maxakuru/esp32-n64/README.md

# esp32-n64

Bluetooth HID gamepad firmware for ESP32. Schematics & designs to fit a USB N64 controller shell.

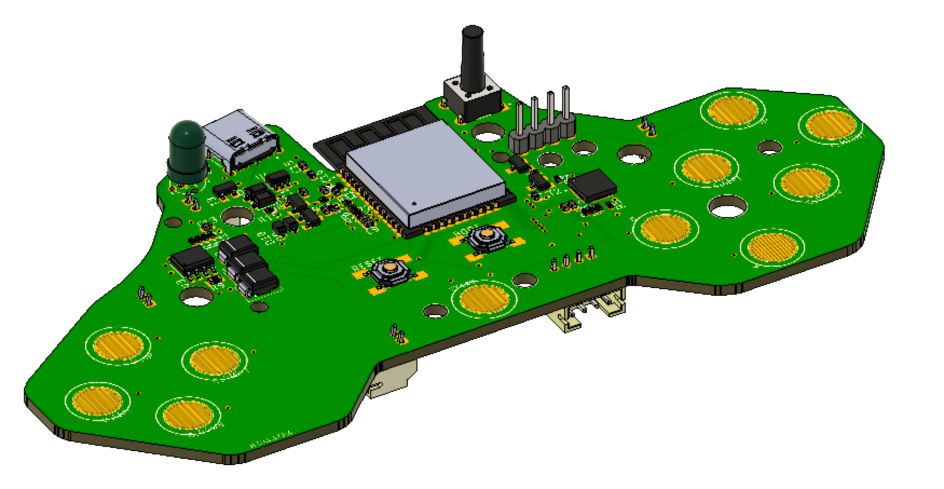
[picture p1: assets/images/board.png]
pcb
