maxakuru/esp32-n64/(threads)

Thread 1 (2022-07-19):

connection problems, android.

davidxgames, 2022-07-19:
hello, i saw your project and it's great, i compiled it and uploaded it to esp32 but when trying to connect to my android phone it gives an error, it's not compatible with android?

davidxgames, 2022-07-19:
i'm using a esp32 dev kit

maxakuru, 2022-07-24:
@davidxgames could you share more details about the error?

This project is still early dev, but I'll try to take a look at an Android phone in the next couple weeks if I can find a device to test with (I use ios). I was able to connect to my Shield TV which uses android, though..
