maxakuru/esp32-n64/assets/pcb/esp-n64.brd

## EAGLE design assets/pcb/esp-n64.brd (2022-07-11)

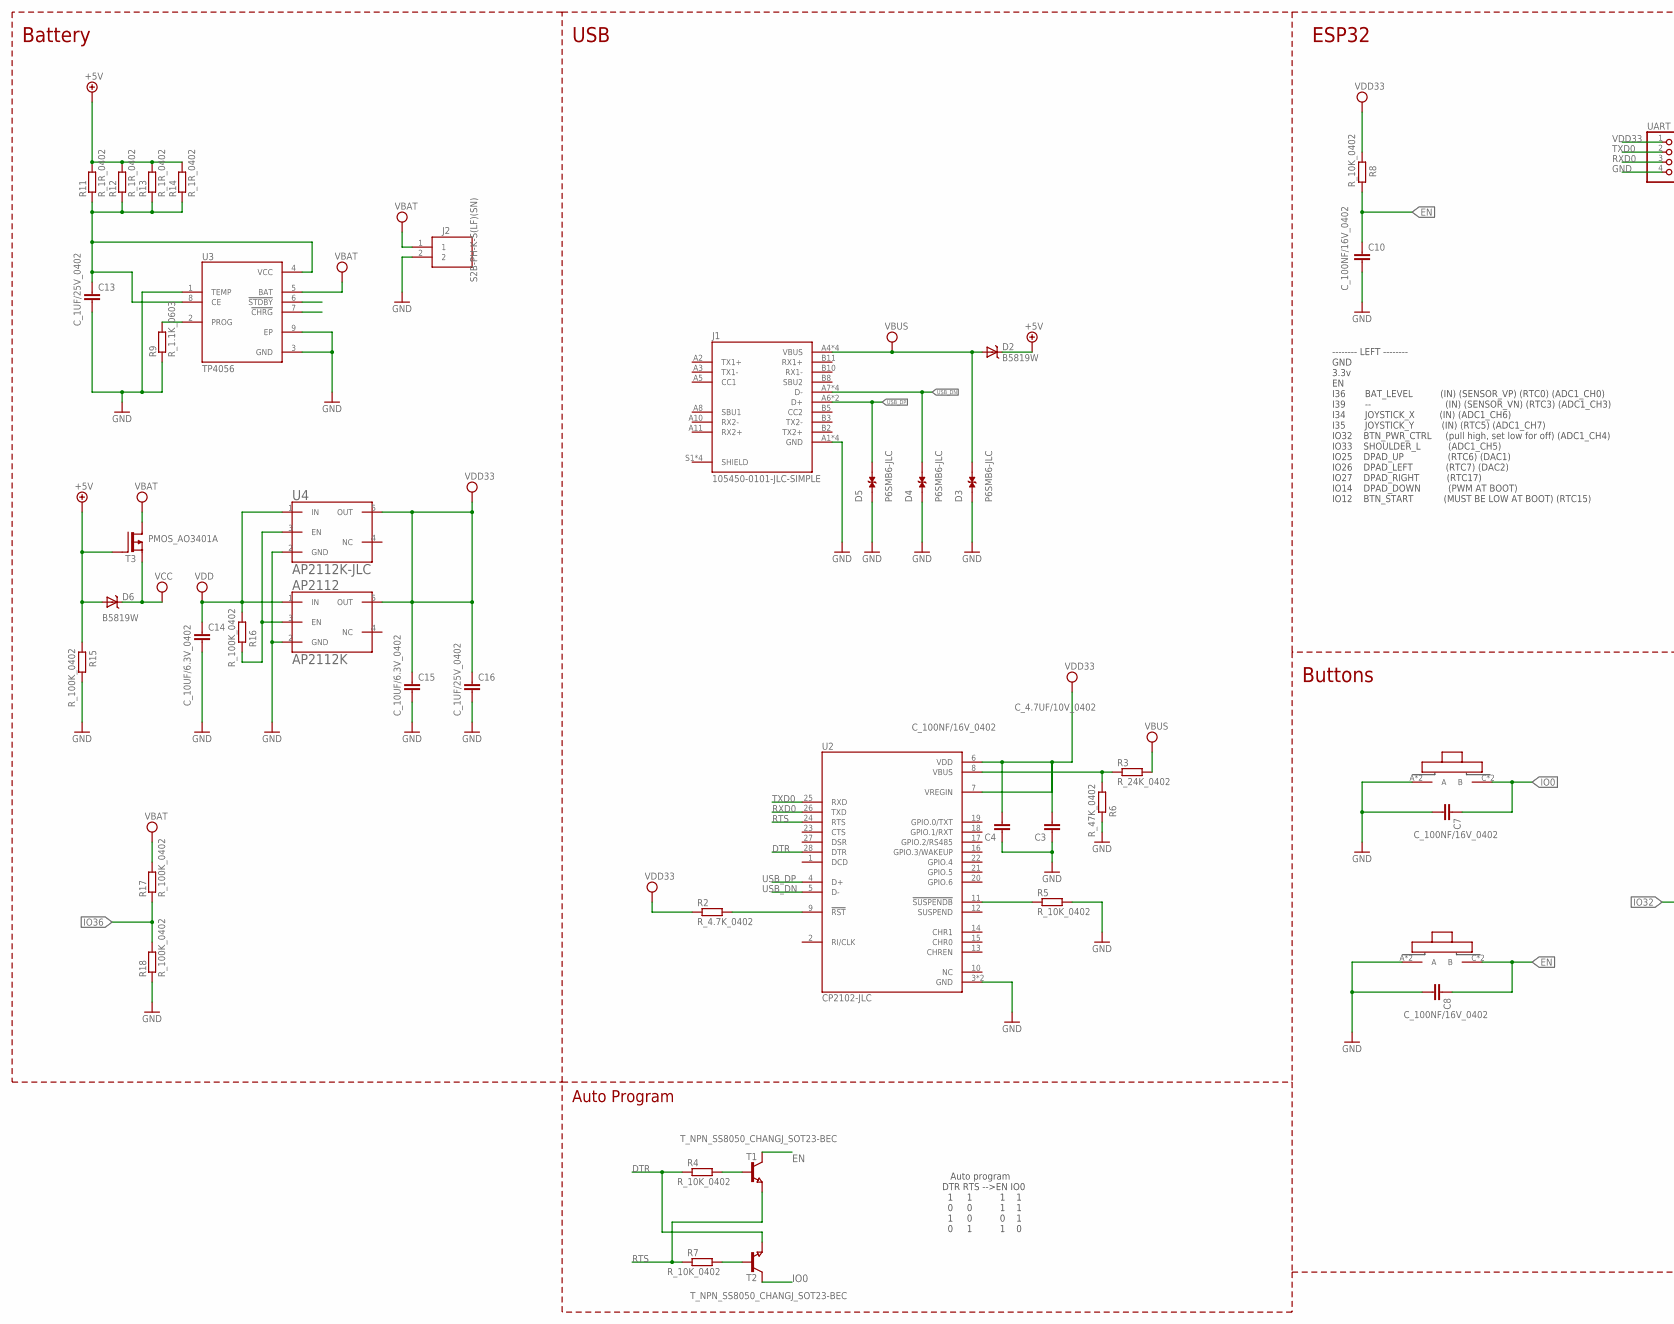
[picture p2: schematic esp-n64.sch, part in row 1, column 1]

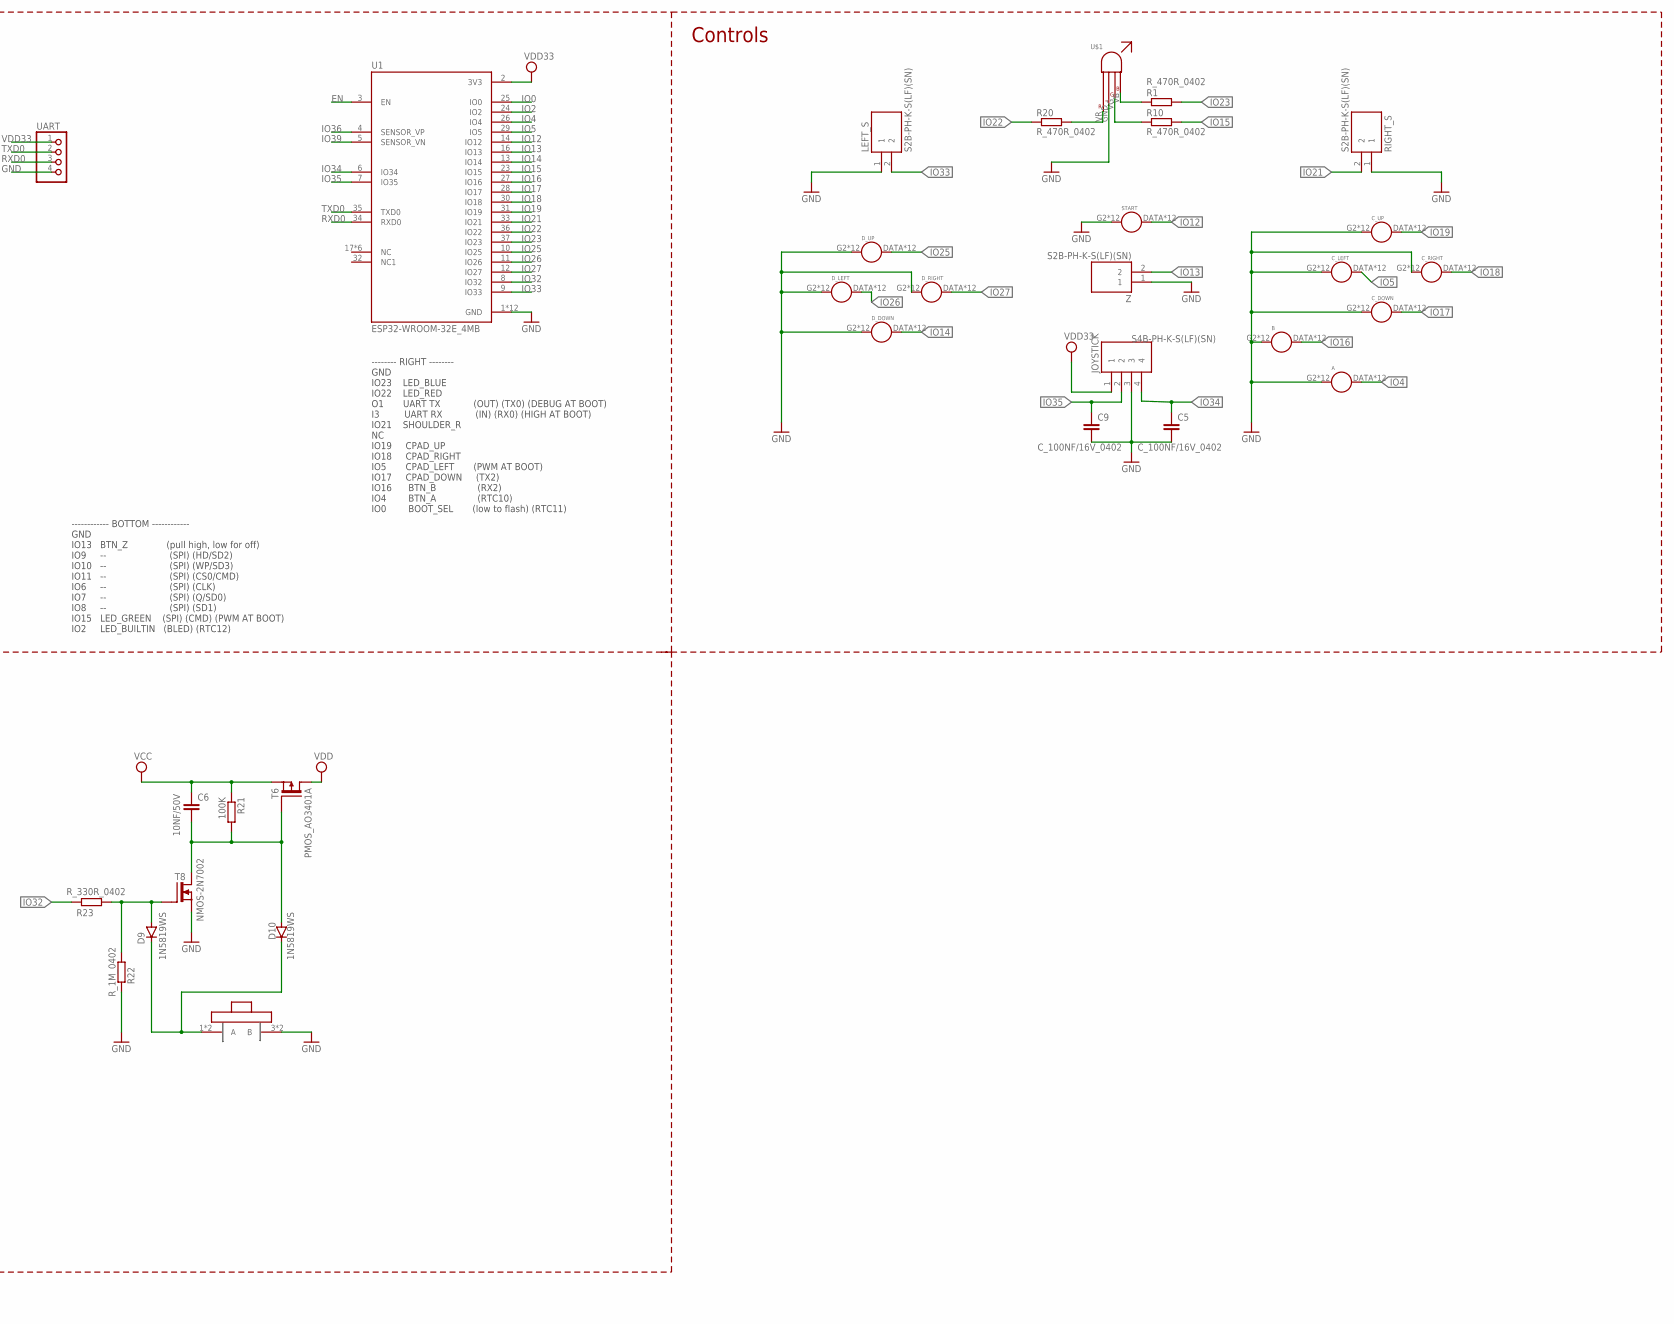
[picture p3: schematic esp-n64.sch, part in row 1, column 2]

Parts:
A: BUTTONPCB-CONDUCTIVE; BUTTON-PAD
AP2112: AP2112K; SOT-23-5
B: BUTTONPCB-CONDUCTIVE; BUTTON-PAD
BOOT: TS1187-SIMPLE; TS1187
C3: C_4.7UF/10V_0402; C0402
C4, C5, C7, C8, C9, C10: C_100NF/16V_0402; C0402
C6: 10NF/50V; C0402
C13, C16: C_1UF/25V_0402; C0402
C14, C15: C_10UF/6.3V_0402; C0402
CTRL: FSM14J-SIMPLE; SW_FSM14J
C_DOWN: BUTTONPCB-CONDUCTIVE; BUTTON-PAD
C_LEFT: BUTTONPCB-CONDUCTIVE; BUTTON-PAD
C_RIGHT: BUTTONPCB-CONDUCTIVE; BUTTON-PAD
C_UP: BUTTONPCB-CONDUCTIVE; BUTTON-PAD
D2, D6: B5819W; SOD-123
D3, D4, D5: P6SMB6-JLC; P6SMB6
D9, D10: 1N5819WS; SOD323
D_DOWN: BUTTONPCB-CONDUCTIVE; BUTTON-PAD
D_LEFT: BUTTONPCB-CONDUCTIVE; BUTTON-PAD
D_RIGHT: BUTTONPCB-CONDUCTIVE; BUTTON-PAD
D_UP: D_UP; BUTTON-PAD
J1: 105450-0101-JLC-SIMPLE; MOLEX_105450-0101-SIMPLE
J2: S2B-PH-K-S(LF)(SN); JST_S2B-PH-K-S(LF)(SN)
JOYSTICK: S4B-PH-K-S(LF)(SN); JST_S4B-PH-K-S(LF)(SN)
LEFT_S: S2B-PH-K-S(LF)(SN); JST_S2B-PH-K-S(LF)(SN)
R1, R10, R20: R_470R_0402; R0402
R2: R_4.7K_0402; R0402
R3: R_24K_0402; R0402
R4, R5, R7, R8: R_10K_0402; R0402
R6: R_47K_0402; R0402
R9: R_1.1K_0603; R0603
R11, R12, R13, R14: R_1R_0402; R0402
R15, R16, R17, R18: R_100K_0402; R0402
R21: 100K; R0402
R22: R_1M_0402; R0402
R23: R_330R_0402; R0402
RESET: TS1187-SIMPLE; TS1187
RIGHT_S: S2B-PH-K-S(LF)(SN); JST_S2B-PH-K-S(LF)(SN)
START: BUTTONPCB-CONDUCTIVE; BUTTON-PAD
T1, T2: T_NPN_SS8050_CHANGJ_SOT23-BEC; SOT23
T3, T6: PMOS_AO3401A; SOT23
T8: NMOS-2N7002; SOT23
U1: ESP32-WROOM-32E_4MB; ESP32-WROOM-32E
U2: CP2102-JLC; QFN50P500X500X80-29N
U3: TP4056; SOP127P600X175-9N
U4: AP2112K-JLC; SOT-23-5
U$1: RGB-LED; 1X04-LED-RGB
UART: PINHD-1X4; 1X04
Z: S2B-PH-K-S(LF)(SN); JST_S2B-PH-K-S(LF)(SN)

Connections:
+5V: D2.C, D6.A, R11.2, R12.2, R13.2, R14.2, R15.2, T3.1 (G)
DTR: R4.1, T2.2 (E), U2.28 (DTR)
EN: C8.1, C10.1, R8.1, RESET.C (B), RESET.D (B), T1.3 (C), U1.3 (EN)
GND: A.G2 (GND), A.G3 (GND), A.G4 (GND), A.G5 (GND), A.G6 (GND), A.G7 (GND), A.G8 (GND), A.G9 (GND), A.G10 (GND), A.G11 (GND), A.G12 (GND), A.GND, AP2112.2 (GND), B.G2 (GND), B.G3 (GND), B.G4 (GND), B.G5 (GND), B.G6 (GND), B.G7 (GND), B.G8 (GND), B.G9 (GND), B.G10 (GND), B.G11 (GND), B.G12 (GND), B.GND, BOOT.A, BOOT.B (A), C3.1, C4.1, C5.2, C7.2, C8.2, C9.2, C10.2, C13.2, C14.2, C15.2, C16.2, CTRL.3 (B), CTRL.4 (B), C_DOWN.G2 (GND), C_DOWN.G3 (GND), C_DOWN.G4 (GND), C_DOWN.G5 (GND), C_DOWN.G6 (GND), C_DOWN.G7 (GND), C_DOWN.G8 (GND), C_DOWN.G9 (GND), C_DOWN.G10 (GND), C_DOWN.G11 (GND), C_DOWN.G12 (GND), C_DOWN.GND, C_LEFT.G2 (GND), C_LEFT.G3 (GND), C_LEFT.G4 (GND), C_LEFT.G5 (GND), C_LEFT.G6 (GND), C_LEFT.G7 (GND), C_LEFT.G8 (GND), C_LEFT.G9 (GND), C_LEFT.G10 (GND), C_LEFT.G11 (GND), C_LEFT.G12 (GND), C_LEFT.GND, C_RIGHT.G2 (GND), C_RIGHT.G3 (GND), C_RIGHT.G4 (GND), C_RIGHT.G5 (GND), C_RIGHT.G6 (GND), C_RIGHT.G7 (GND), C_RIGHT.G8 (GND), C_RIGHT.G9 (GND), C_RIGHT.G10 (GND), C_RIGHT.G11 (GND), C_RIGHT.G12 (GND), C_RIGHT.GND, C_UP.G2 (GND), C_UP.G3 (GND), C_UP.G4 (GND), C_UP.G5 (GND), C_UP.G6 (GND), C_UP.G7 (GND), C_UP.G8 (GND), C_UP.G9 (GND), C_UP.G10 (GND), C_UP.G11 (GND), C_UP.G12 (GND), C_UP.GND, D3.1, D4.1, D5.1, D_DOWN.G2 (GND), D_DOWN.G3 (GND), D_DOWN.G4 (GND), D_DOWN.G5 (GND), D_DOWN.G6 (GND), D_DOWN.G7 (GND), D_DOWN.G8 (GND), D_DOWN.G9 (GND), D_DOWN.G10 (GND), D_DOWN.G11 (GND), D_DOWN.G12 (GND), D_DOWN.GND, D_LEFT.G2 (GND), D_LEFT.G3 (GND), D_LEFT.G4 (GND), D_LEFT.G5 (GND), D_LEFT.G6 (GND), D_LEFT.G7 (GND), D_LEFT.G8 (GND), D_LEFT.G9 (GND), D_LEFT.G10 (GND), D_LEFT.G11 (GND), D_LEFT.G12 (GND), D_LEFT.GND, D_RIGHT.G2 (GND), D_RIGHT.G3 (GND), D_RIGHT.G4 (GND), D_RIGHT.G5 (GND), D_RIGHT.G6 (GND), D_RIGHT.G7 (GND), D_RIGHT.G8 (GND), D_RIGHT.G9 (GND), D_RIGHT.G10 (GND), D_RIGHT.G11 (GND), D_RIGHT.G12 (GND), D_RIGHT.GND, D_UP.G2 (GND), D_UP.G3 (GND), D_UP.G4 (GND), D_UP.G5 (GND), D_UP.G6 (GND), D_UP.G7 (GND), D_UP.G8 (GND), D_UP.G9 (GND), D_UP.G10 (GND), D_UP.G11 (GND), D_UP.G12 (GND), D_UP.GND, J1.A1 (GND), J1.A12 (GND), J1.B1 (GND), J1.B12 (GND), J2.2, JOYSTICK.3, LEFT_S.1, R5.2, R6.1, R9.1, R15.1, R18.1, R22.2, RESET.A, RESET.B (A), RIGHT_S.1, START.G2 (GND), START.G3 (GND), START.G4 (GND), START.G5 (GND), START.G6 (GND), START.G7 (GND), START.G8 (GND), START.G9 (GND), START.G10 (GND), START.G11 (GND), START.G12 (GND), START.GND, T8.2 (S), U1.1 (GND), U1.15 (GND), U1.38 (GND), U1.39_1 (GND), U1.39_2 (GND), U1.39_3 (GND), U1.39_4 (GND), U1.39_5 (GND), U1.39_6 (GND), U1.39_7 (GND), U1.39_8 (GND), U1.39_9 (GND), U2.3 (GND), U2.29 (GND), U3.1 (TEMP), U3.3 (GND), U3.9 (EP), U4.2 (GND), U$1.GND, UART.4, Z.1
IO0: BOOT.C (B), BOOT.D (B), C7.1, T2.3 (C), U1.25 (IO0)
IO2: U1.24 (IO2)
IO4: A.DATA (D), A.DATA2 (D), A.DATA3 (D), A.DATA4 (D), A.DATA5 (D), A.DATA6 (D), A.DATA7 (D), A.DATA8 (D), A.DATA9 (D), A.DATA10 (D), A.DATA11 (D), A.DATA12 (D), U1.26 (IO4)
IO5: C_LEFT.DATA (D), C_LEFT.DATA2 (D), C_LEFT.DATA3 (D), C_LEFT.DATA4 (D), C_LEFT.DATA5 (D), C_LEFT.DATA6 (D), C_LEFT.DATA7 (D), C_LEFT.DATA8 (D), C_LEFT.DATA9 (D), C_LEFT.DATA10 (D), C_LEFT.DATA11 (D), C_LEFT.DATA12 (D), U1.29 (IO5)
IO12: START.DATA (D), START.DATA2 (D), START.DATA3 (D), START.DATA4 (D), START.DATA5 (D), START.DATA6 (D), START.DATA7 (D), START.DATA8 (D), START.DATA9 (D), START.DATA10 (D), START.DATA11 (D), START.DATA12 (D), U1.14 (IO12)
IO13: U1.16 (IO13), Z.2
IO14: D_DOWN.DATA (D), D_DOWN.DATA2 (D), D_DOWN.DATA3 (D), D_DOWN.DATA4 (D), D_DOWN.DATA5 (D), D_DOWN.DATA6 (D), D_DOWN.DATA7 (D), D_DOWN.DATA8 (D), D_DOWN.DATA9 (D), D_DOWN.DATA10 (D), D_DOWN.DATA11 (D), D_DOWN.DATA12 (D), U1.13 (IO14)
IO15: R10.2, U1.23 (IO15)
IO16: B.DATA (D), B.DATA2 (D), B.DATA3 (D), B.DATA4 (D), B.DATA5 (D), B.DATA6 (D), B.DATA7 (D), B.DATA8 (D), B.DATA9 (D), B.DATA10 (D), B.DATA11 (D), B.DATA12 (D), U1.27 (IO16)
IO17: C_DOWN.DATA (D), C_DOWN.DATA2 (D), C_DOWN.DATA3 (D), C_DOWN.DATA4 (D), C_DOWN.DATA5 (D), C_DOWN.DATA6 (D), C_DOWN.DATA7 (D), C_DOWN.DATA8 (D), C_DOWN.DATA9 (D), C_DOWN.DATA10 (D), C_DOWN.DATA11 (D), C_DOWN.DATA12 (D), U1.28 (IO17)
IO18: C_RIGHT.DATA (D), C_RIGHT.DATA2 (D), C_RIGHT.DATA3 (D), C_RIGHT.DATA4 (D), C_RIGHT.DATA5 (D), C_RIGHT.DATA6 (D), C_RIGHT.DATA7 (D), C_RIGHT.DATA8 (D), C_RIGHT.DATA9 (D), C_RIGHT.DATA10 (D), C_RIGHT.DATA11 (D), C_RIGHT.DATA12 (D), U1.30 (IO18)
IO19: C_UP.DATA (D), C_UP.DATA2 (D), C_UP.DATA3 (D), C_UP.DATA4 (D), C_UP.DATA5 (D), C_UP.DATA6 (D), C_UP.DATA7 (D), C_UP.DATA8 (D), C_UP.DATA9 (D), C_UP.DATA10 (D), C_UP.DATA11 (D), C_UP.DATA12 (D), U1.31 (IO19)
IO21: RIGHT_S.2, U1.33 (IO21)
IO22: R20.1, U1.36 (IO22)
IO23: R1.2, U1.37 (IO23)
IO25: D_UP.DATA (D), D_UP.DATA2 (D), D_UP.DATA3 (D), D_UP.DATA4 (D), D_UP.DATA5 (D), D_UP.DATA6 (D), D_UP.DATA7 (D), D_UP.DATA8 (D), D_UP.DATA9 (D), D_UP.DATA10 (D), D_UP.DATA11 (D), D_UP.DATA12 (D), U1.10 (IO25)
IO26: D_LEFT.DATA (D), D_LEFT.DATA2 (D), D_LEFT.DATA3 (D), D_LEFT.DATA4 (D), D_LEFT.DATA5 (D), D_LEFT.DATA6 (D), D_LEFT.DATA7 (D), D_LEFT.DATA8 (D), D_LEFT.DATA9 (D), D_LEFT.DATA10 (D), D_LEFT.DATA11 (D), D_LEFT.DATA12 (D), U1.11 (IO26)
IO27: D_RIGHT.DATA (D), D_RIGHT.DATA2 (D), D_RIGHT.DATA3 (D), D_RIGHT.DATA4 (D), D_RIGHT.DATA5 (D), D_RIGHT.DATA6 (D), D_RIGHT.DATA7 (D), D_RIGHT.DATA8 (D), D_RIGHT.DATA9 (D), D_RIGHT.DATA10 (D), D_RIGHT.DATA11 (D), D_RIGHT.DATA12 (D), U1.12 (IO27)
IO32: R23.1, U1.8 (IO32)
IO33: LEFT_S.2, U1.9 (IO33)
IO34: C5.1, JOYSTICK.4, U1.6 (IO34)
IO35: C9.1, JOYSTICK.2, U1.7 (IO35)
IO36: R17.1, R18.2, U1.4 (SENSOR_VP)
IO39: U1.5 (SENSOR_VN)
unnamed: R20.2, U$1.VR
unnamed: AP2112.3 (EN), R16.1, U4.3 (EN)
unnamed: D9.A, R22.1, R23.2, T8.1 (G)
unnamed: R10.1, U$1.VG
unnamed: R4.2, T1.1 (B)
unnamed: R7.2, T2.1 (B)
unnamed: C13.1, R11.1, R12.1, R13.1, R14.1, U3.4 (VCC), U3.8 (CE)
unnamed: R1.1, U$1.VB
unnamed: R2.2, U2.9 (!RST)
unnamed: R3.1, R6.2, U2.8 (VBUS)
unnamed: C6.2, D10.A, R21.2, T6.1 (G), T8.3 (D)
unnamed: R9.2, U3.2 (PROG)
unnamed: R5.1, U2.11 (!SUSPENDB)
unnamed: CTRL.1 (A), CTRL.2 (A), D9.C, D10.C
RTS: R7.1, T1.2 (E), U2.24 (RTS)
RXD0: U1.34 (RXD0), U2.26 (TXD), UART.3
TXD0: U1.35 (TXD0), U2.25 (RXD), UART.2
USB_DN: D4.2, J1.A7 (D-), J1.B7 (D-), J1.P$1 (D-), J1.P$2 (D-), U2.5 (D-)
USB_DP: D5.2, J1.A6 (D+), J1.B6 (D+), U2.4 (D+)
VBAT: J2.1, R17.2, T3.3 (D), U3.5 (BAT)
VBUS: D2.A, D3.2, J1.A4 (VBUS), J1.A9 (VBUS), J1.B4 (VBUS), J1.B9 (VBUS), R3.2
VCC: C6.1, D6.C, R21.1, T3.2 (S), T6.2 (S)
VDD: AP2112.1 (IN), C14.1, R16.2, T6.3 (D), U4.1 (IN)
VDD33: AP2112.5 (OUT), C3.2, C4.2, C15.1, C16.1, JOYSTICK.1, R2.1, R8.2, U1.2 (3V3), U2.6 (VDD), U2.7 (VREGIN), U4.5 (OUT), UART.1

Notes on the sheet:
Buttons
ESP32
USB
Battery
Auto Program
Auto program DTR RTS -->EN IO0 1 1 1 1 0 0 1 1 1 0 0 1 0 1 1 0
-------- LEFT -------- GND 3.3v EN I36 BAT_LEVEL (IN) (SENSOR_VP) (RTC0) (ADC1_CH0) I39 -- (IN) (SENSOR_VN) (RTC3) (ADC1_CH3) I34 JOYSTICK_X (IN) (ADC1_CH6) I35 JOYSTICK_Y (IN) (RTC5) (ADC1_CH7) IO32 BTN_PWR_CTRL (pull high, set low for off) (ADC1_CH4) IO33 SHOULDER_L (ADC1_CH5) IO25 DPAD_UP (RTC6)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
------------ BOTTOM ------------ GND IO13 BTN_Z (pull high, low for off) IO9 -- (SPI) (HD/SD2) IO10 -- (SPI) (WP/SD3) IO11 -- (SPI) (CS0/CMD) IO6 -- (SPI) (CLK) IO7 -- (SPI) (Q/SD0) IO8 -- (SPI) (SD1) IO15 LED_GREEN (SPI) (CMD) (PWM AT BOOT) IO2 LED_BUILTIN (BLED) (RTC12)
Controls
-------- RIGHT -------- GND IO23 LED_BLUE IO22 LED_RED O1 UART TX (OUT) (TX0) (DEBUG AT BOOT) I3 UART RX (IN) (RX0) (HIGH AT BOOT) IO21 SHOULDER_R NC IO19 CPAD_UP IO18 CPAD_RIGHT IO5 CPAD_LEFT (PWM AT BOOT) IO17 CPAD_DOWN (TX2) IO16 BTN_B (RX2) IO4 BTN_A (RTC10) IO0 BOOT_SEL (low to flash) (RTC11)

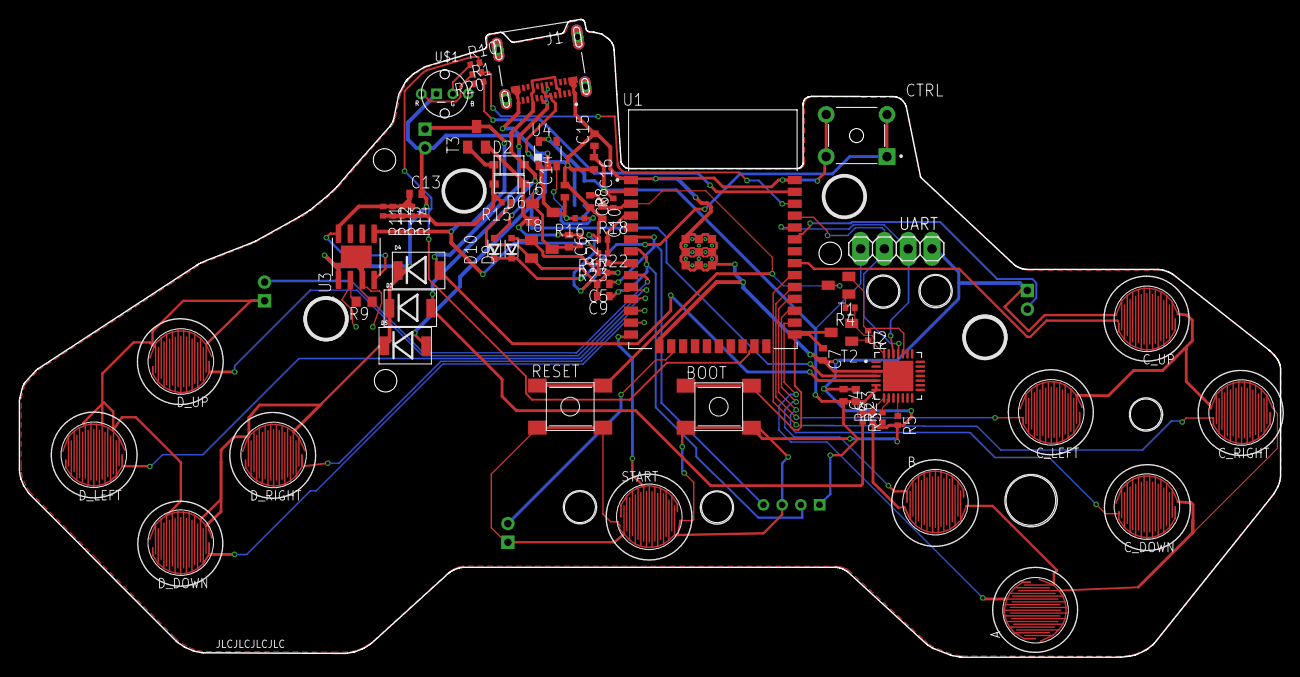
[picture p4: board esp-n64.brd from above]

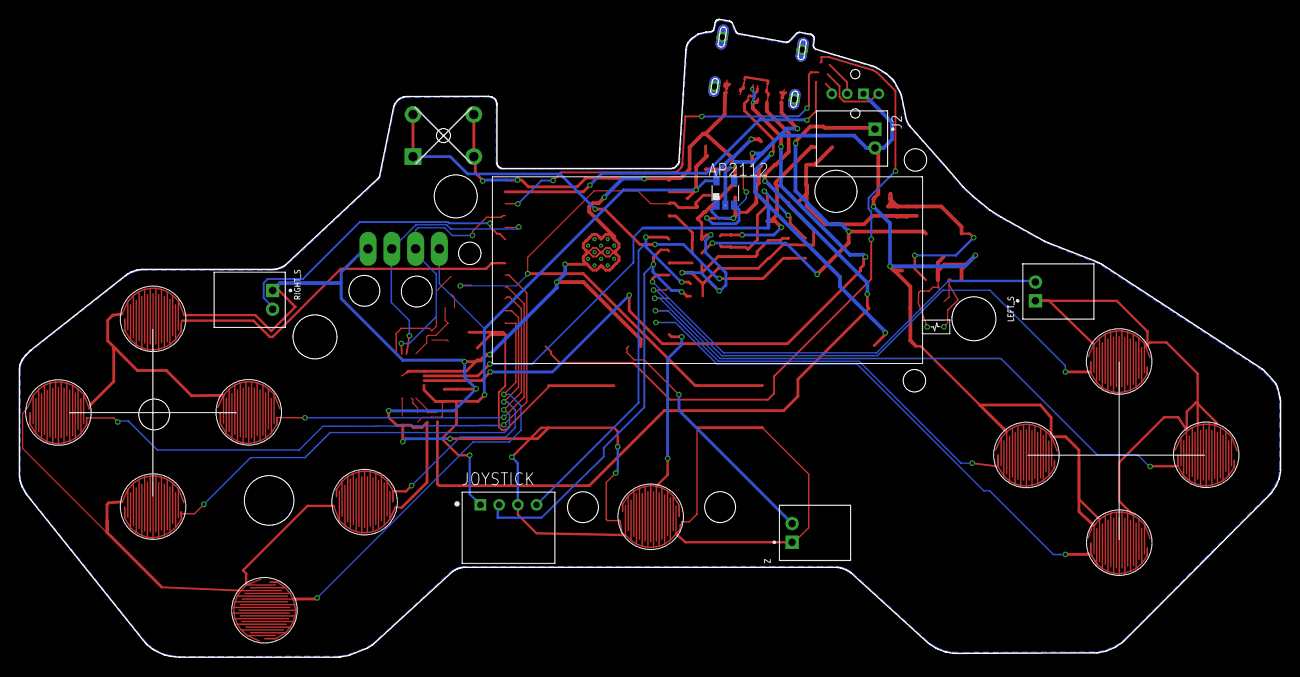
[picture p5: board esp-n64.brd from below]

Board: 2 copper layers, 134.7 x 68.1 mm, 73 parts (6 on the bottom side), 50 nets.
