maxakuru/esp32-n64/(commit log)

2022-05-31 remove usb host logic, use interrupts on pins directly
2022-07-11 add board image
